botblox/SPEBlox-Module-Documentation/README.md

# SPEBlox-Module-Documentation
Design files associated with SPEBlox Module for Design Integration
