botblox/SPEBlox-Module-Documentation/BB-SPEMEVAL-A-1 BREAKOUT BOARD DESIGN FILES/Manufacture Files/BB-SPEMEVAL-A-1.xlsx

Reference | Value | Datasheet | MPN | Qty
C1,C2 | 0.1uF | ~ | GRM155R71H104KE14J | 2
D1,D2 | GREEN | ~ | APHHS1005CGCK | 2
J1 | BB-SPEM-A-1 |  | DNP | 1
J2,J3,J4 | 691210910002 | ~ | 691210910002 | 3
J5 | Conn_01x02_Pin | ~ | M20-9990246 | 1
J6 | ARJM11D7-502-AB-EW2 |  | ARJM11D7-502-AB-EW2:ABRACON_ARJM11D7-502-AB-EW2 | 1
R1 | 1K | ~ | RC0402FR-071KL | 1
R2 | 2.2K | ~ | RC0402FR-072K2L | 1
