botblox/SPEBlox-Module-Documentation/3D CAD/BB-SPEM-A-1 3D CAD.step

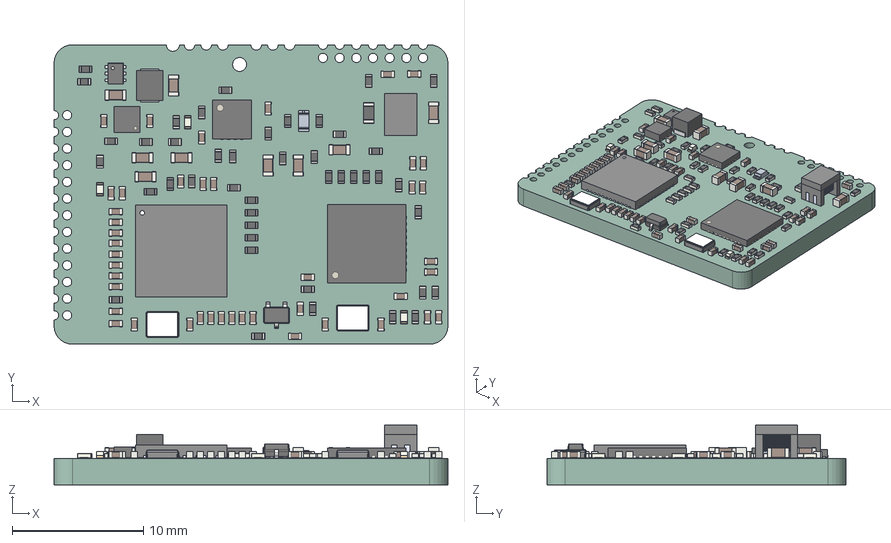
[picture p1: CAD file, 2025-07-15]
3D CAD/BB-SPEM-A-1 3D CAD.step
30.0 x 22.8 x 4.55 mm
R_0402_1005Metric x 44
C_0402_1005Metric x 43
C_0603_1608Metric x 9
QFN-36-1EP_6x6mm_Pitch0.5mm
RGZ48A
QFN-16-1EP_3x3mm_Pitch0.5mm
SML-D22
ECX-2236 x 2
LED_0402_1005Metric x 3
WSON_6_1EP_2x2mm_P065mm_EP1x16mm
User Library-INDM2520X190N
SOT_563
SOT_323_SC_70
R_0603_1608Metric
SPEBloxRevF2_PCB
