botblox/SPEBlox-Module-Documentation/BB-SPEMEVAL-A-1 BREAKOUT BOARD DESIGN FILES/PDF/Gerbers (PDF)/BB-SPEM-A-1 Breakout-F_Silkscreen.pdf

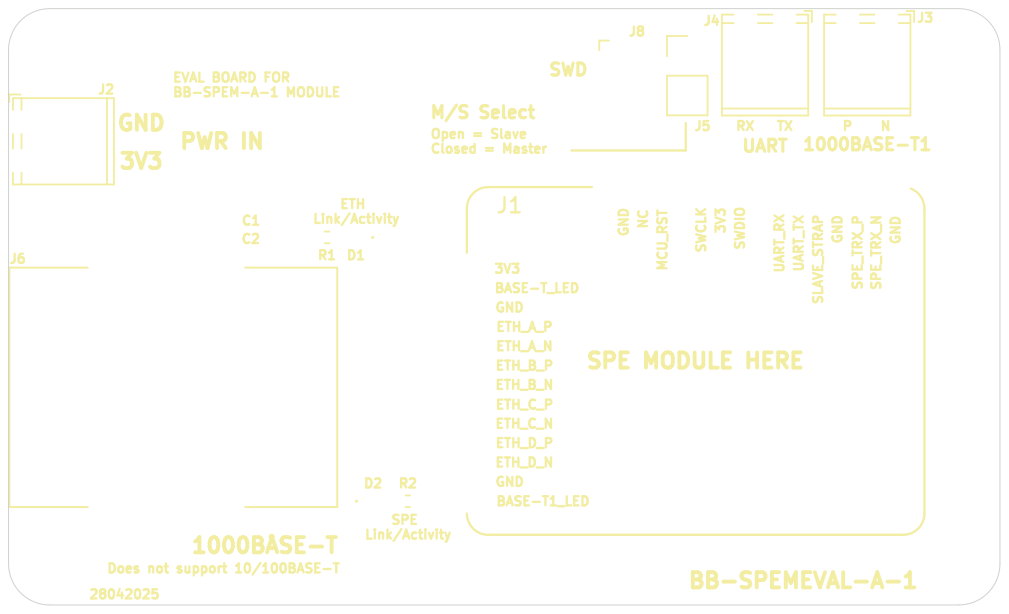
[picture p2: page 1]

Open = Slave Closed = Master GND
BB-SPEMEVAL-A-1 PWR IN
