botblox/SPEBlox-Module-Documentation/BB-SPEMEVAL-A-1 BREAKOUT BOARD DESIGN FILES/PDF/BB-SPEM-A-1 Breakout Schematic.pdf

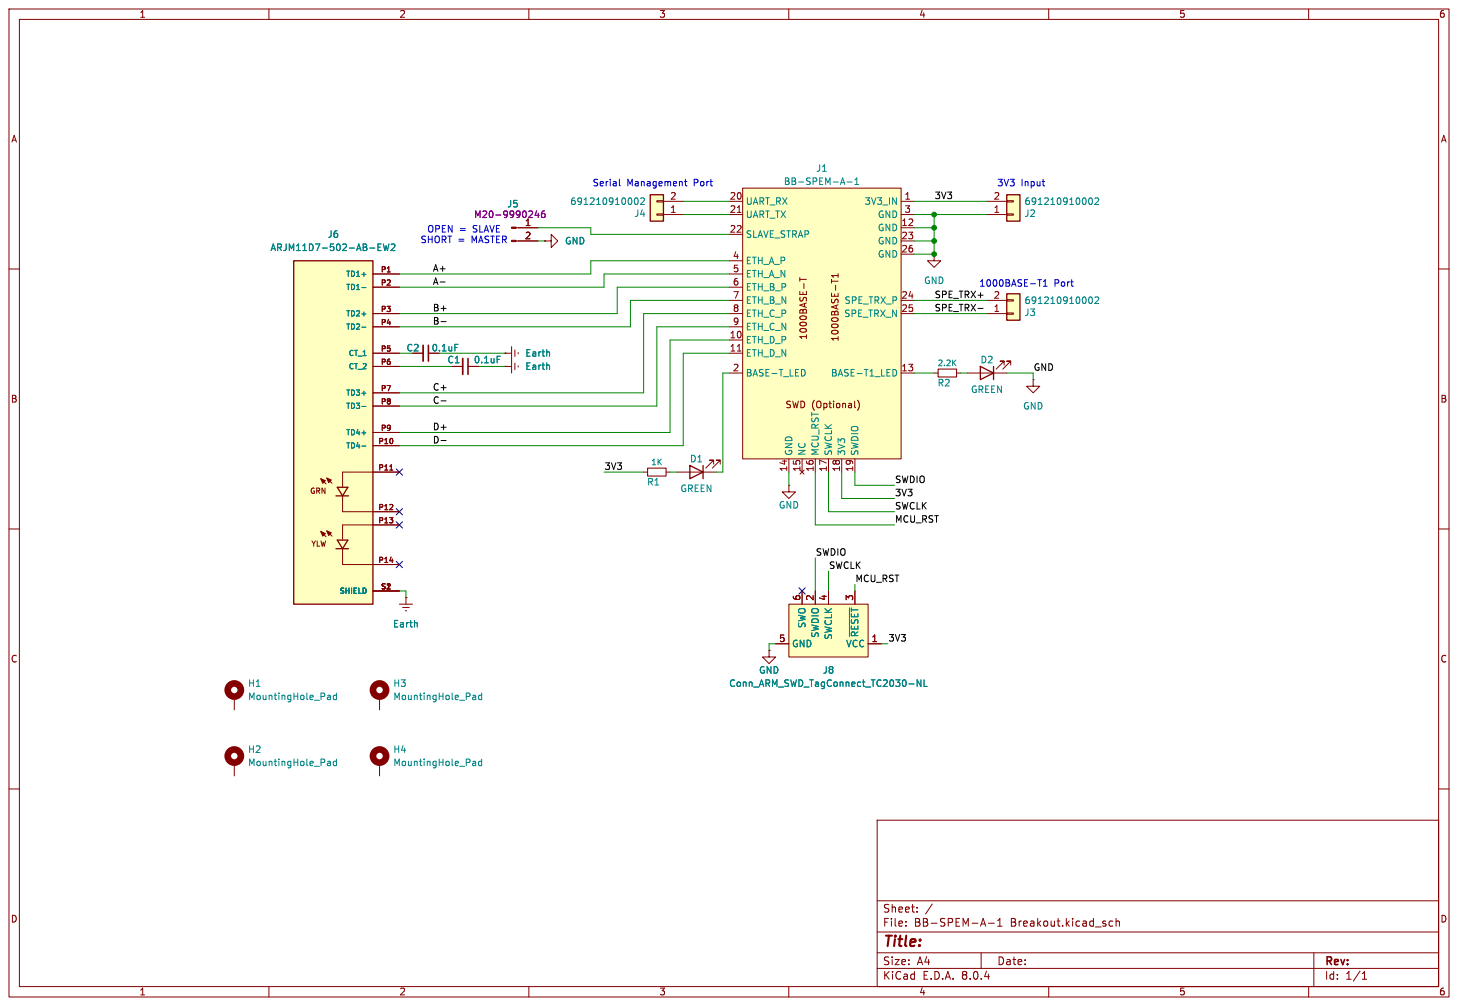
[picture p3: page 1]
