botblox/SPEBlox-Module-Documentation/BB-SPEMEVAL-A-1 BREAKOUT BOARD DESIGN FILES/PDF/Gerbers (PDF)/BB-SPEM-A-1 Breakout-B_Cu.pdf

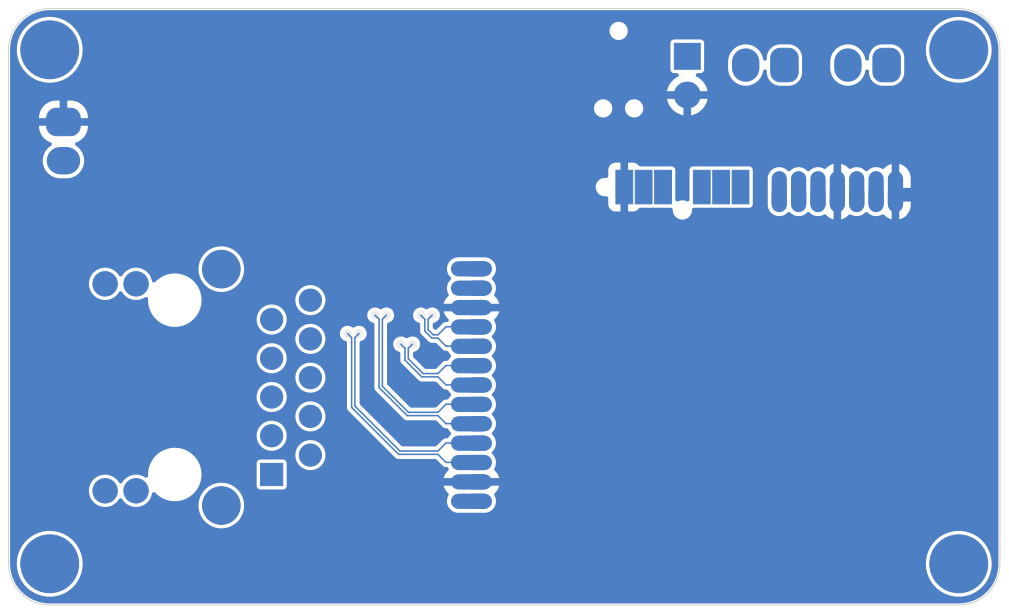
[picture p4: page 1]
