botblox/SPEBlox-Module-Documentation/BB-SPEMEVAL-A-1 BREAKOUT BOARD DESIGN FILES/PDF/Gerbers (PDF)/BB-SPEM-A-1 Breakout-B_Mask.pdf

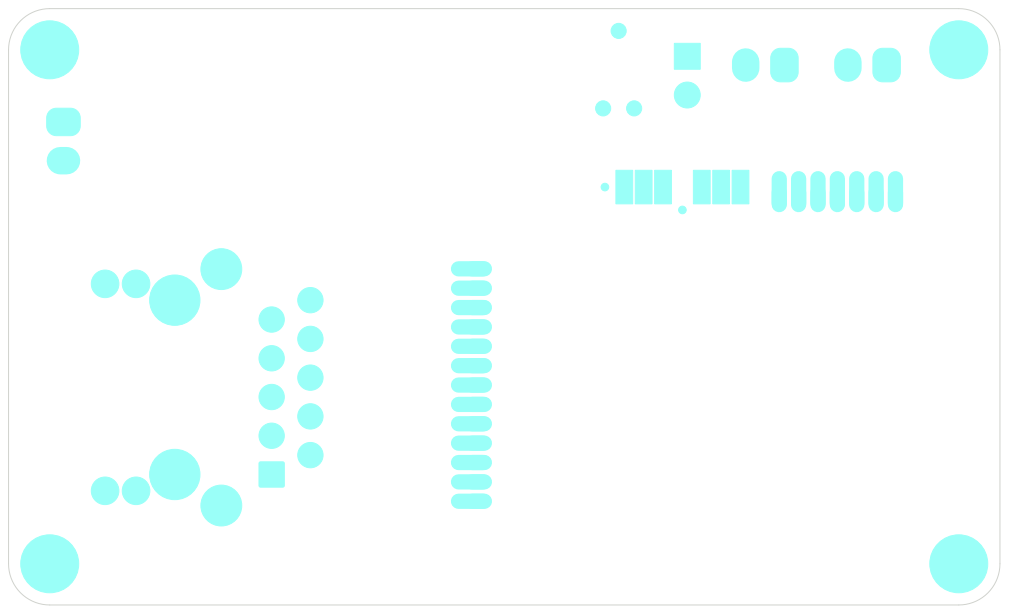
[picture p5: page 1]
