botblox/SPEBlox-Module-Documentation/BB-SPEMEVAL-A-1 BREAKOUT BOARD DESIGN FILES/PDF/Gerbers (PDF)/BB-SPEM-A-1 Breakout-B_Paste.pdf

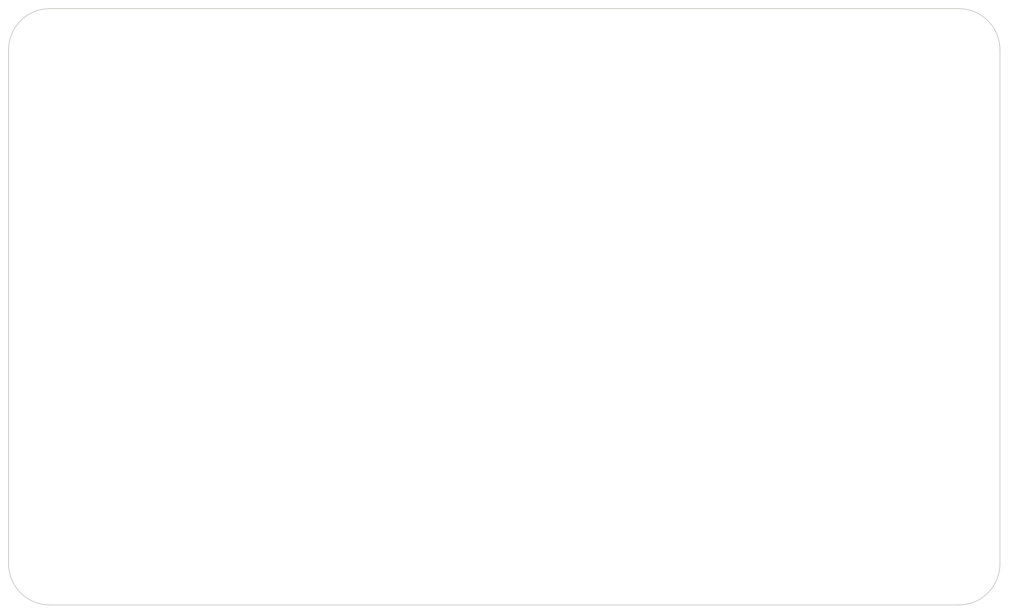
[picture p6: page 1]
