botblox/SPEBlox-Module-Documentation/BB-SPEMEVAL-A-1 BREAKOUT BOARD DESIGN FILES/PDF/Gerbers (PDF)/BB-SPEM-A-1 Breakout-F_Cu.pdf

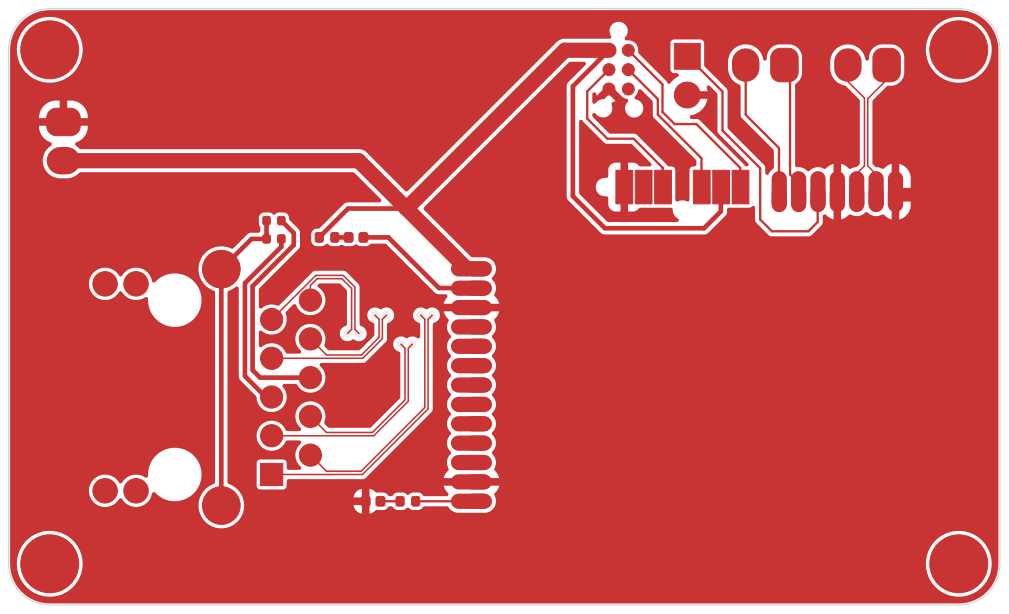
[picture p7: page 1]
