botblox/SPEBlox-Module-Documentation/BB-SPEMEVAL-A-1 BREAKOUT BOARD DESIGN FILES/Source Kicad Files/BB-SPEM-A-1 Breakout.kicad_pcb

## KiCad design BB-SPEMEVAL-A-1 BREAKOUT BOARD DESIGN FILES/Source Kicad Files/BB-SPEM-A-1 Breakout.kicad_pcb (2025-07-15)

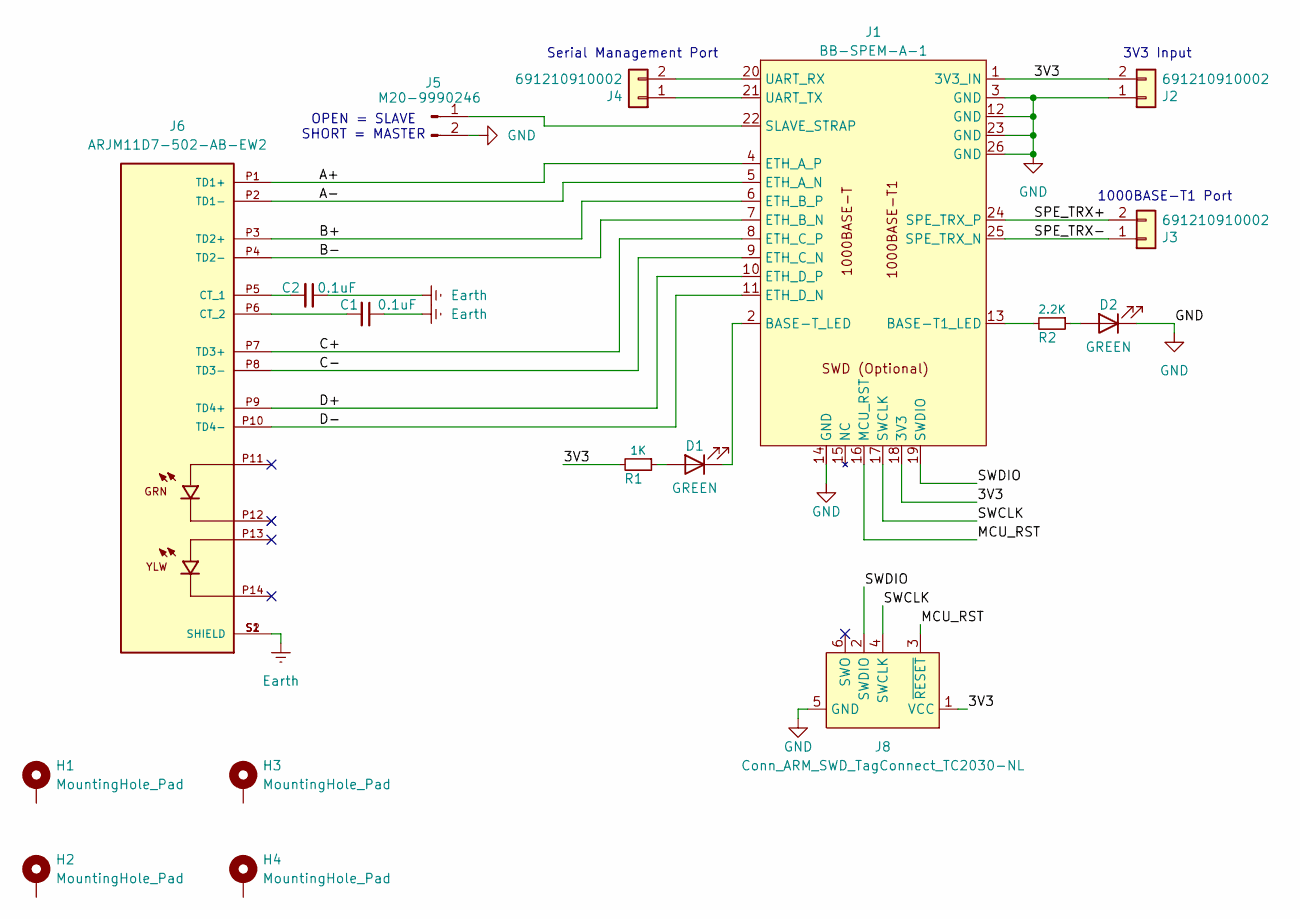
[picture p12: schematic BB-SPEM-A-1 Breakout.kicad_sch]

Parts:
C1, C2: 0.1uF; C_0402_Small; Voltage Rating 50V; MPN GRM155R71H104KE14J; LCSC# C85858
D1, D2: GREEN; LED_0402_1005Metric; Voltage Rating 2.1V; MPN APHHS1005CGCK
H1, H2, H3, H4: MountingHole_Pad; MountingHole_2.2mm_M2_DIN965_Pad
J1: BB-SPEM-A-1; BB-SPEM-A-1_Footprint
J2, J3, J4: 691210910002; TerminalBlock_WurthElektronik_691210910002_1x02_P2.54mm_Hor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; MPN 691210910002; LCSC# C474920
J5: Conn_01x02_Pin; PinHeader_1x02_P2.54mm_Vertical; MPN M20-9990246
J6: ARJM11D7-502-AB-EW2; ABRACON_ARJM11D7-502-AB-EW2; MPN ARJM11D7-502-AB-EW2
J8: Conn_ARM_SWD_TagConnect_TC2030-NL; Tag-Connect_TC2030-IDC-NL_2x03_P1.27mm_Vertical
R1: 1K; R_0402_1005Metric; Tolerance 1%; MPN RC0402FR-071KL; LCSC# C106235
R2: 2.2K; R_0402_1005Metric; Tolerance 1%; MPN RC0402FR-072K2L; LCSC# C114762

Connections:
/3V3: J1.1 (3V3_IN), J1.18 (3V3), J2.2, J8.1 (VCC), R1.2
/A+: J1.4 (ETH_A_P), J6.P1 (TD1+)
/A-: J1.5 (ETH_A_N), J6.P2 (TD1-)
/B+: J1.6 (ETH_B_P), J6.P3 (TD2+)
/B-: J1.7 (ETH_B_N), J6.P4 (TD2-)
/C+: J1.8 (ETH_C_P), J6.P7 (TD3+)
/C-: J1.9 (ETH_C_N), J6.P8 (TD3-)
/D+: J1.10 (ETH_D_P), J6.P9 (TD4+)
/D-: J1.11 (ETH_D_N), J6.P10 (TD4-)
/MCU_RST: J1.16 (MCU_RST), J8.3 (~RESET)
/SPE_TRX+: J1.24 (SPE_TRX_P), J3.2
/SPE_TRX-: J1.25 (SPE_TRX_N), J3.1
/SWCLK: J1.17 (SWCLK), J8.4 (SWCLK)
/SWDIO: J1.19 (SWDIO), J8.2 (SWDIO)
Earth: C1.1, C2.1, J6.S1 (SHIELD), J6.S2 (SHIELD)
GND: D2.1 (K), J1.3 (GND), J1.12 (GND), J1.14 (GND), J1.23 (GND), J1.26 (GND), J2.1, J5.2, J8.5 (GND)
unnamed: D1.2 (A), R1.1
unnamed: D1.1 (K), J1.2 (BASE-T_LED)
unnamed: D2.2 (A), R2.1
unnamed: J1.13 (BASE-T1_LED), R2.2
unnamed: J1.22 (SLAVE_STRAP), J5.1
unnamed: J1.20 (UART_RX), J4.2
unnamed: J1.21 (UART_TX), J4.1
unnamed: C2.2, J6.P5 (CT_1)
unnamed: C1.2, J6.P6 (CT_2)

Notes on the sheet:
Serial Management Port
OPEN = SLAVE SHORT = MASTER
3V3 Input
1000BASE-T1 Port

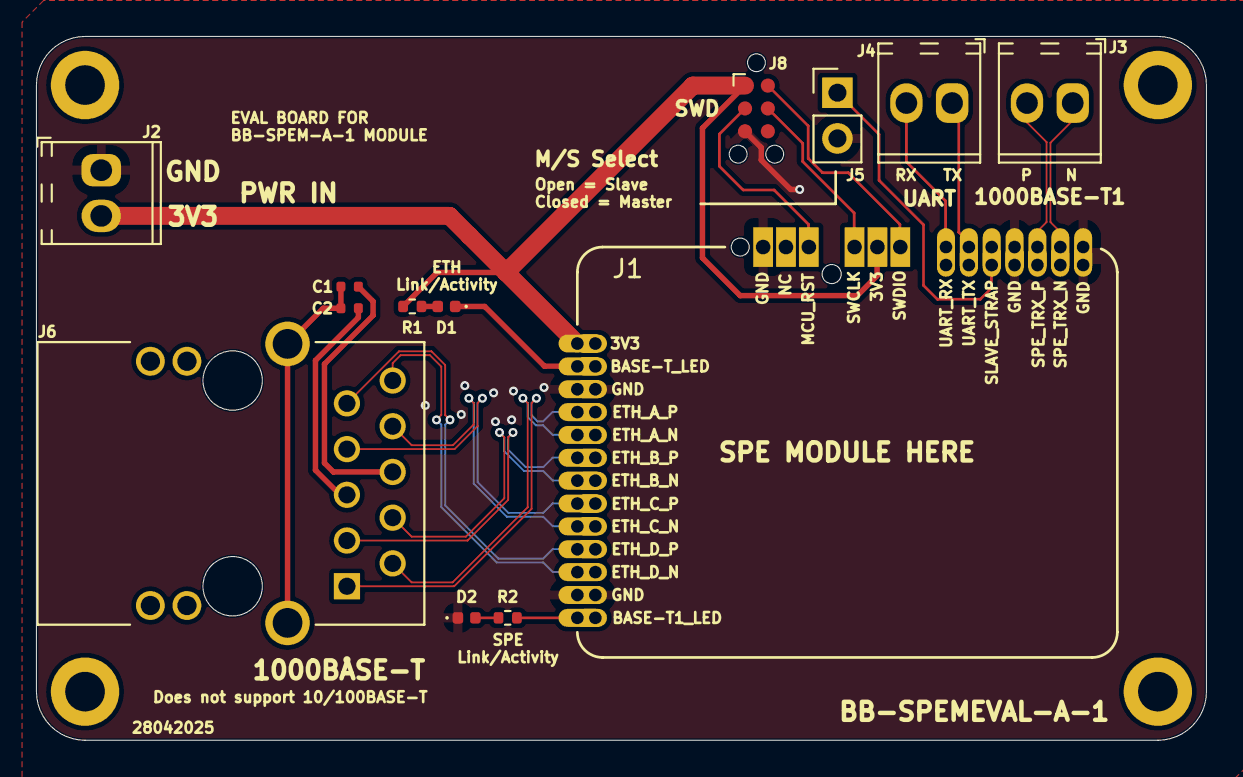
[picture p13: board BB-SPEM-A-1 Breakout.kicad_pcb from above]

Board: 4 copper layers, 65.0 x 39.1 mm, 17 parts (0 on the bottom side), 25 nets.
