botblox/SPEBlox-Module-Documentation/BB-SPEMEVAL-A-1 BREAKOUT BOARD DESIGN FILES/Manufacture Files/3D Images/Top.png

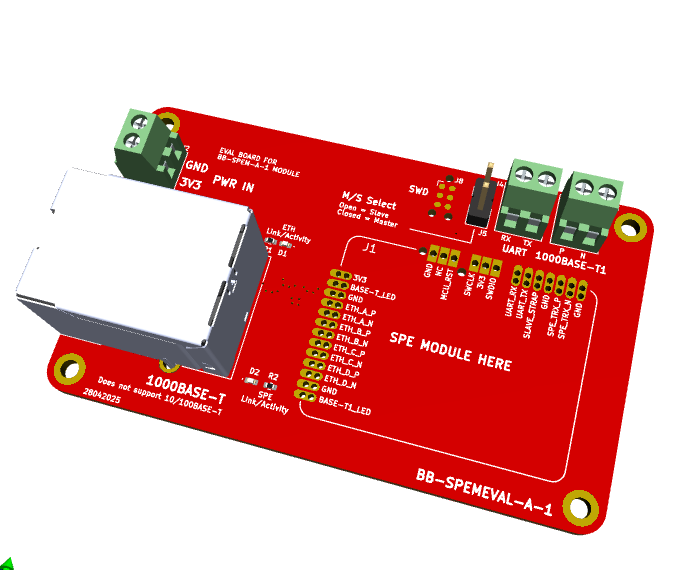
BB-SPEMEVAL-A-1 BREAKOUT BOARD DESIGN FILES/Manufacture Files/3D Images/Top.png
